razdo227/Rezo---Haptic-Metronome/docs/PROJECT_OS.md

# Rezo Haptic Metronome — Project OS

## Delivery targets
- EVT + protocol-ready sprint: **2026-03-17**
- Final polished delivery: **2026-04-03**

## Workstreams
1. Hardware (KiCad + PCB + DFM)
2. Firmware (timing + haptic engine + BLE)
3. Research (protocol + pilot + main study)
4. Paper (rolling draft -> final submission)

## Decision policy (Tax default)
- Tax makes day-to-day execution decisions by default.
- Ask Avadhoot only when a decision changes budget, external submissions, participant safety/ethics, or irreversible fabrication choices.

## Weekly cadence
- Mon: architecture/risk review
- Tue-Wed: deep build days
- Thu: integration + test
- Fri: study/paper updates
- Sat/Sun: backlog cleanup + next sprint prep

## GitHub setup
Milestones:
- Sprint-2W (EVT + Study Protocol)
- Final-1M (Polished Delivery)

Core issues are pre-created and should be kept updated daily.

## Notification cadence (for Calendar/Tasks)
- Daily 09:00: plan top 3 tasks
- Daily 20:30: status + blockers log
- T-7, T-3, T-1 reminders for each milestone deliverable
