razdo227/Rezo---Haptic-Metronome/Kicad Schematics/rezo_v0.1.kicad_pcb

## KiCad design Kicad Schematics/rezo_v0.1.kicad_pcb (2026-03-04)

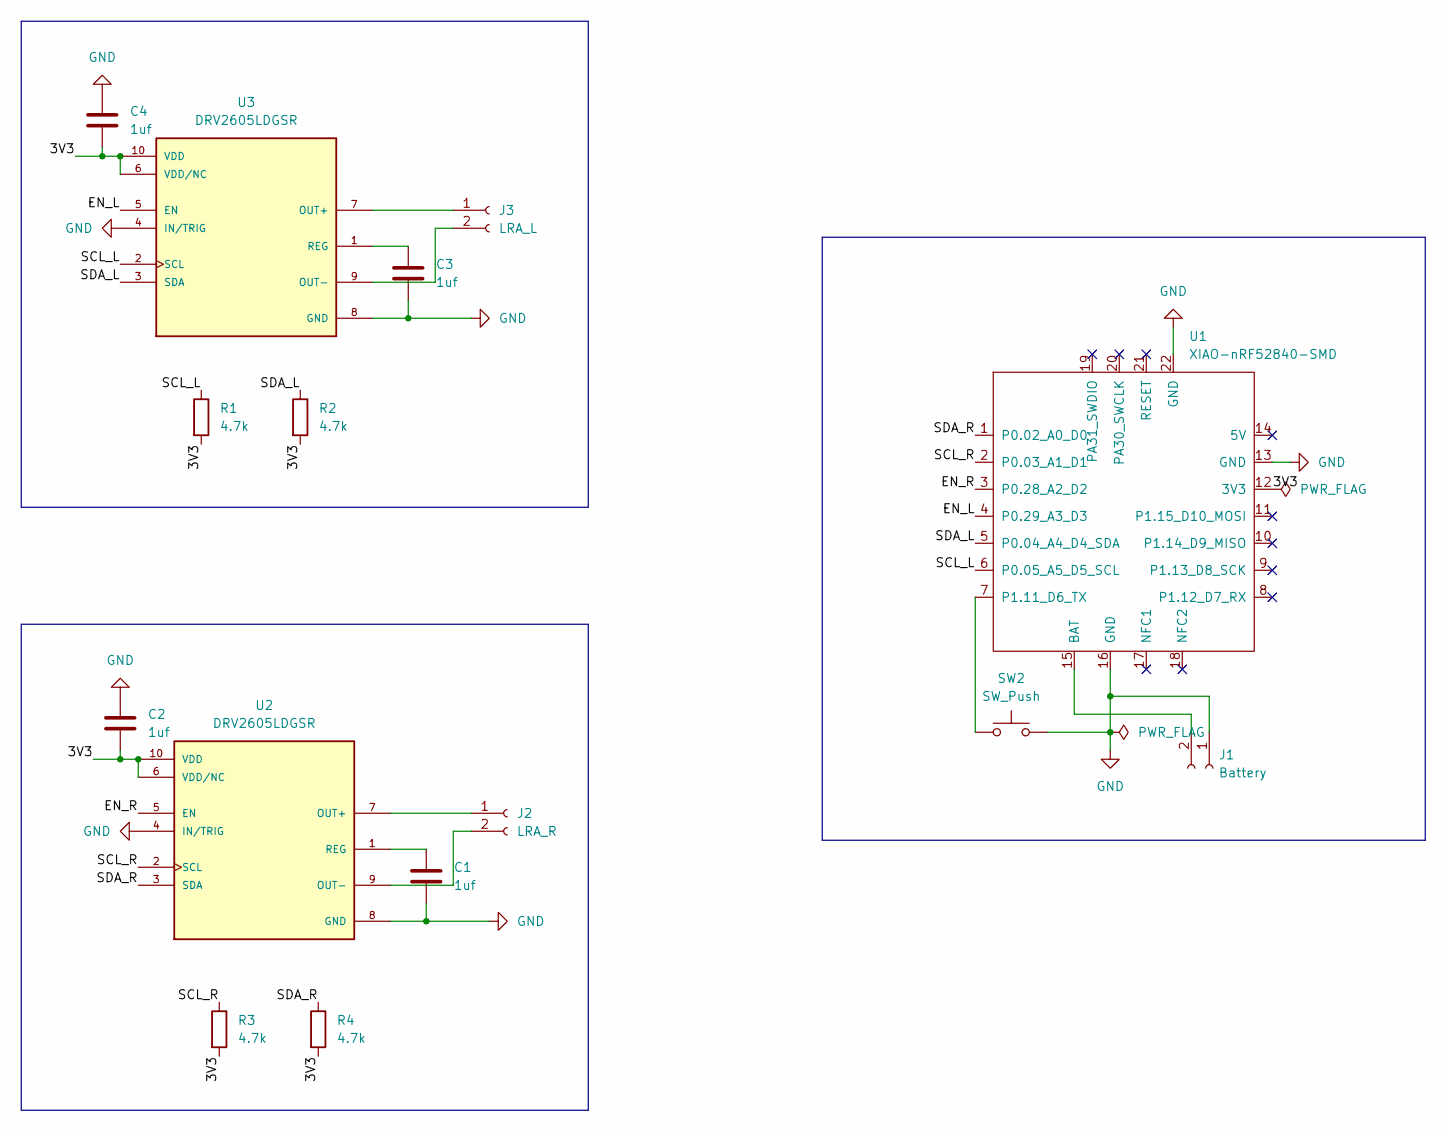
[picture p1: schematic rezo_v0.1.kicad_sch]

Parts:
C1, C2, C3, C4: 1uf; C_0603_1608Metric
J1: Battery; SolderWire-0.1sqmm_1x02_P3.6mm_D0.4mm_OD1mm
J2: LRA_R; BOURNS_70AAJ-2-M0
J3: LRA_L; BOURNS_70AAJ-2-M0
R1, R2, R3, R4: 4.7k; R_0603_1608Metric
SW2: SW_Push; SW_SPST_B3S-1000
U1: XIAO-nRF52840-SMD
U2, U3: DRV2605LDGSR; PARTREV D

Connections:
/3V3: C2.2, C4.2, R1.2, R2.2, R3.2, R4.2, U1.12 (3V3), U2.6 (VDD/NC), U2.10 (VDD), U3.6 (VDD/NC), U3.10 (VDD)
/EN_L: U1.4 (P0.29_A3_D3), U3.5 (EN)
/EN_R: U1.3 (P0.28_A2_D2), U2.5 (EN)
/SCL_L: R1.1, U1.6 (P0.05_A5_D5_SCL), U3.2 (SCL)
/SCL_R: R3.1, U1.2 (P0.03_A1_D1), U2.2 (SCL)
/SDA_L: R2.1, U1.5 (P0.04_A4_D4_SDA), U3.3 (SDA)
/SDA_R: R4.1, U1.1 (P0.02_A0_D0), U2.3 (SDA)
GND: C1.2, C2.1, C3.2, C4.1, J1.1, SW2.2, U1.13 (GND), U1.16 (GND), U1.22 (GND), U2.4 (IN/TRIG), U2.8 (GND), U3.4 (IN/TRIG), U3.8 (GND)
unnamed: J1.2, U1.15 (BAT)
unnamed: J2.1, U2.7 (OUT+)
unnamed: J2.2, U2.9 (OUT-)
unnamed: J3.1, U3.7 (OUT+)
unnamed: J3.2, U3.9 (OUT-)
unnamed: SW2.1, U1.7 (P1.11_D6_TX)
unnamed: C1.1, U2.1 (REG)
unnamed: C3.1, U3.1 (REG)

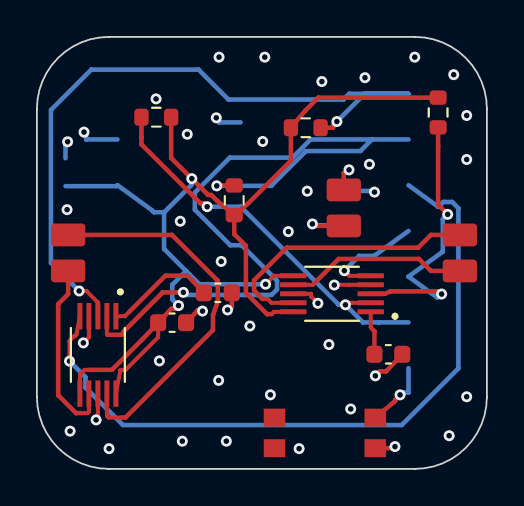
[picture p2: board rezo_v0.1.kicad_pcb from above]

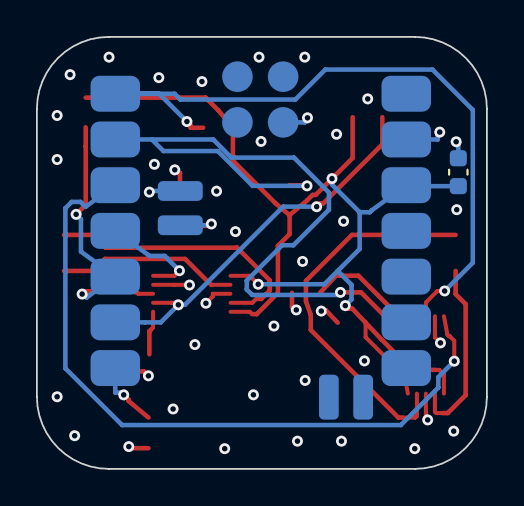
[picture p3: board rezo_v0.1.kicad_pcb from below]

Board: 4 copper layers, 25.0 x 24.0 mm, 15 parts (2 on the bottom side), 16 nets.
