razdo227/Rezo---Haptic-Metronome/(commit log)

2026-03-03 Add KiCad schematic/PCB next-step checklist for v0.2
2026-03-03 Add v0.1 2-layer/4-layer KiCad + JLC manufacturing playbook
2026-03-04 Tune KiCad DRC constraints and mask settings; generate DRC/ERC reports
    [rezo_v0.1.kicad_pcb]
2026-03-04 Clean silkscreen DRC warnings; reduce board DRC to library-only warnings
    [rezo_v0.1.kicad_pcb]
2026-03-12 Add Arduino-ready XIAO nRF52840 firmware sketch for DRV2605 with BLE control
2026-03-12 Add multi-pattern haptics in firmware and wire app BLE commands to device protocol
2026-03-12 Stabilize Expo entrypoint, BLE transport wiring, and EAS build config
2026-03-12 Rebuild app with explicit BLE pairing screen, manual device selection, and placeholder icons
2026-03-13 firmware: add pairing LED pattern and startup haptic cue
2026-03-13 Implement stable BLE-first mobile controller flow
2026-03-30 fix: resolve dual-version merge conflicts and compilation errors
    [RezoHaptic.ino]
2026-03-30 fix: use Seeeduino:mbed core — restore MbedI2C, correct AR_INTERNAL2V4
    [RezoHaptic.ino]
2026-03-30 fix: switch to LRA mode (useLRA + library 6) for VLV101040A motors, fix waveform slot clearing
    [RezoHaptic.ino]
2026-03-30 fix: remove useLRA() closed-loop tracking, keep library 6
    [RezoHaptic.ino]
2026-03-30 fix: use LRA open-loop mode at 175Hz for VLV101040A — stable without calibration
    [RezoHaptic.ino]
2026-03-30 fix: revert DRV2605 to library 1 (ERM) — waveform IDs are library 1 numbering
    All effect IDs in WAVEFORMS_NORMAL and WAVEFORMS_ACCENT are from the
    DRV2605L library 1 (ERM) ROM. Switching to library 6 (LRA) caused the
    wrong waveforms to play since the effect catalog is different per library.
    Also removes useLRA() and the open-loop 175 Hz register writes — these
    were causing off-resonance and unpredictable feel without calibration.
    [RezoHaptic.ino]
2026-03-31 feat: LRA calibration, unified cross-platform pattern vocabulary, research mode
    Firmware:
    - Add DRV2605L auto-calibration on boot (autoCalibrate()) with RATED_VOLTAGE/OD_CLAMP
    tuned for Vybronics VLV101040A (1.8 V rated, 2.25 V overdrive)
    - Revise all 16 waveform patterns to short, defined LRA effects; recalibrate cutoff times
    - Downbeat accent unified to waveform 5 (Strong Click 100%) across all patterns
    Cross-platform parity:
    - GATTConstants.h: add PLUGIN_PRESET_TO_FIRMWARE[] table as authoritative UI→firmware mapping
    - Plugin: 4 presets → 7 presets matching mobile display names exactly; default changed to Pulse
    - PluginProcessor: pushPatternCmd reads from PLUGIN_PRESET_TO_FIRMWARE[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
    [RezoHaptic.ino]
2026-03-31 fix: resolve build errors for Seeeduino:mbed BSP
    - Restore arduino::MbedI2C WireR(D2, D3) — correct type for mbed BSP
    (Seeeduino:nrf52 uses TwoWire/Wire1; Seeeduino:mbed uses MbedI2C)
    - Replace drv.autoCalibrate() with setMode(AUTOCAL)+go()+delay(1300)
    since Adafruit DRV2605 lib v1.2.4 does not expose autoCalibrate()
    - Keep AR_INTERNAL2V4 — correct constant name on mbed BSP variant
    Compiles clean against Seeeduino:mbed:xiaonRF52840Sense 2.9.3.
    Flashed to hardware successfully.
    [RezoHaptic.ino]
