razdo227/Rezo---Haptic-Metronome/(notices)

Notices in the files:
README.md:
License: MIT
